Connaxio/servo-valve/servo_valve.FCStd

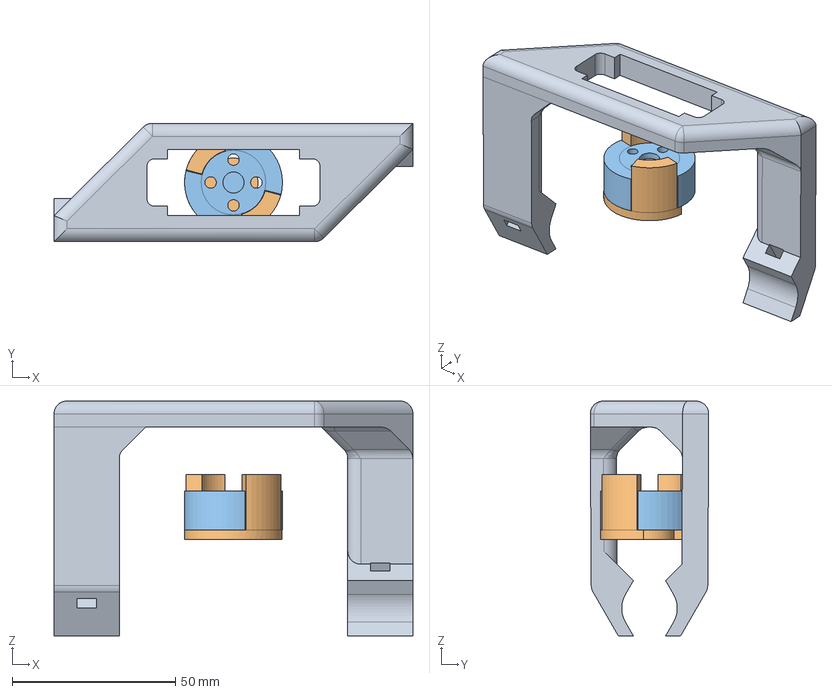
[picture p4: CAD file, 2022-09-26]
servo_valve.FCStd
110.0 x 36.3 x 72.0 mm
