Connaxio/servo-valve/STL/servo_valve-bracket.stl

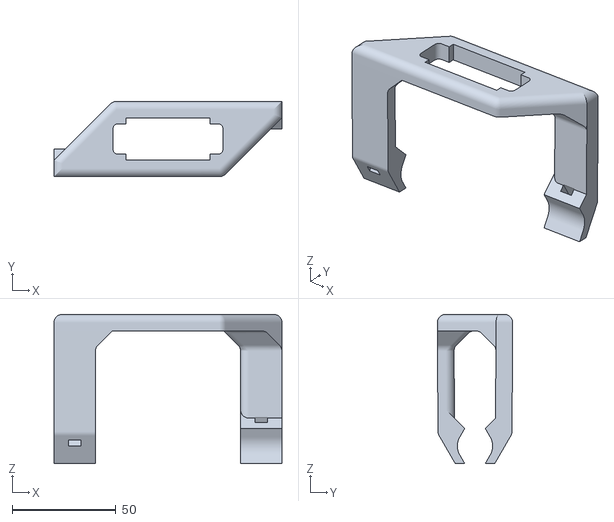
[picture p5: CAD file, 2022-10-03]
STL/servo_valve-bracket.stl
110.0 x 36.3 x 72.0
