Connaxio/servo-valve/STL/servo_valve-Lever_bottom.stl

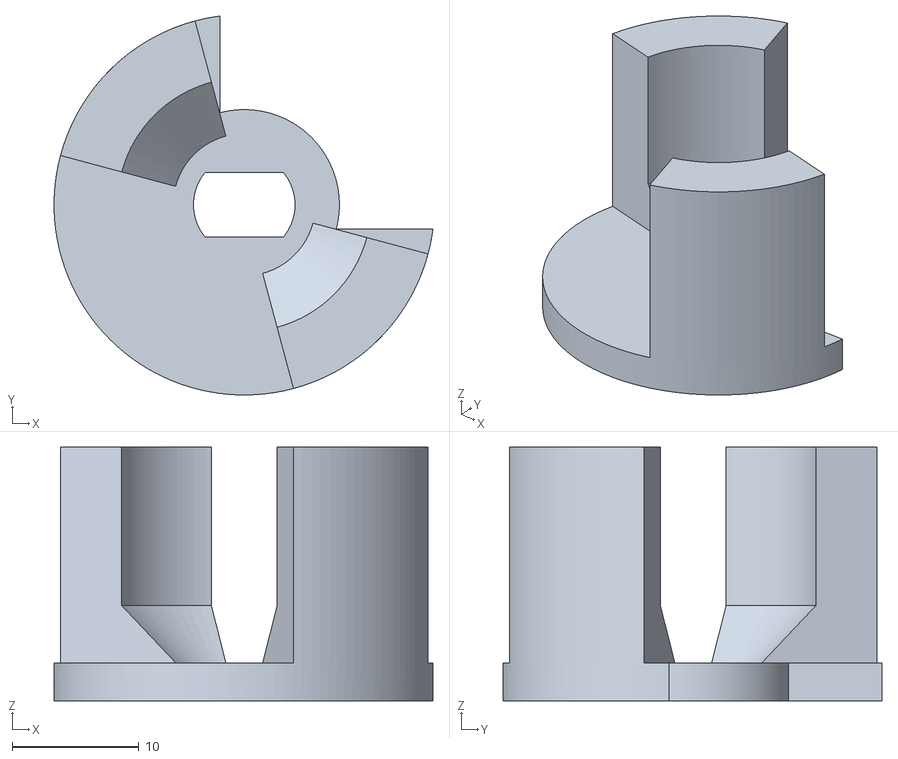
[picture p6: CAD file, 2022-09-26]
STL/servo_valve-Lever_bottom.stl
29.9 x 29.9 x 20.0
