Connaxio/servo-valve/STL/servo_valve-Lever_top.stl

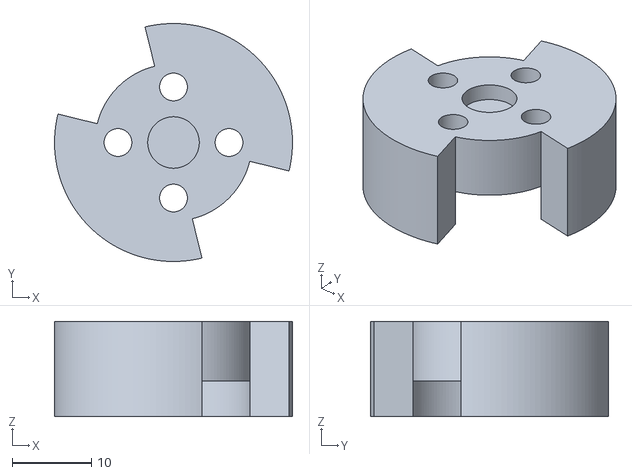
[picture p7: CAD file, 2022-09-26]
STL/servo_valve-Lever_top.stl
30.0 x 30.0 x 12.0
