Connaxio/servo-valve/(commit log)

2022-09-26 Add valve and README
    [servo_valve-Lever_bottom.stl, servo_valve-Lever_top.stl, servo_valve-bracket.stl, servo_valve.FCStd]
2022-10-03 Update STL file
    [servo_valve-bracket.stl]
